tenphuc/Clock-Digital-with-Emotional-Face-and-Environment-Sensors/PROJECT/HW/CLKE.pdf

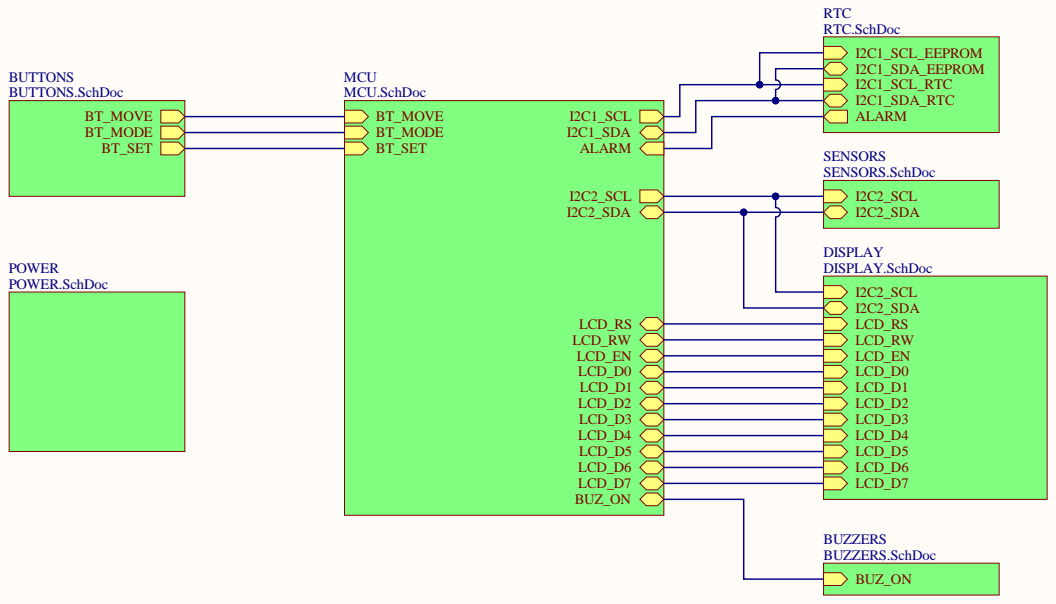
[picture p2: page 1]

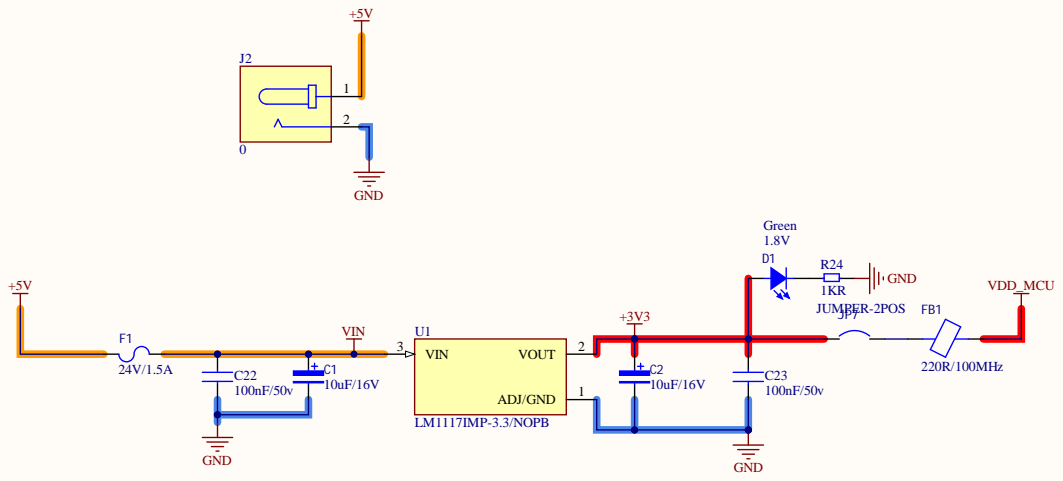
[picture p3: page 2]

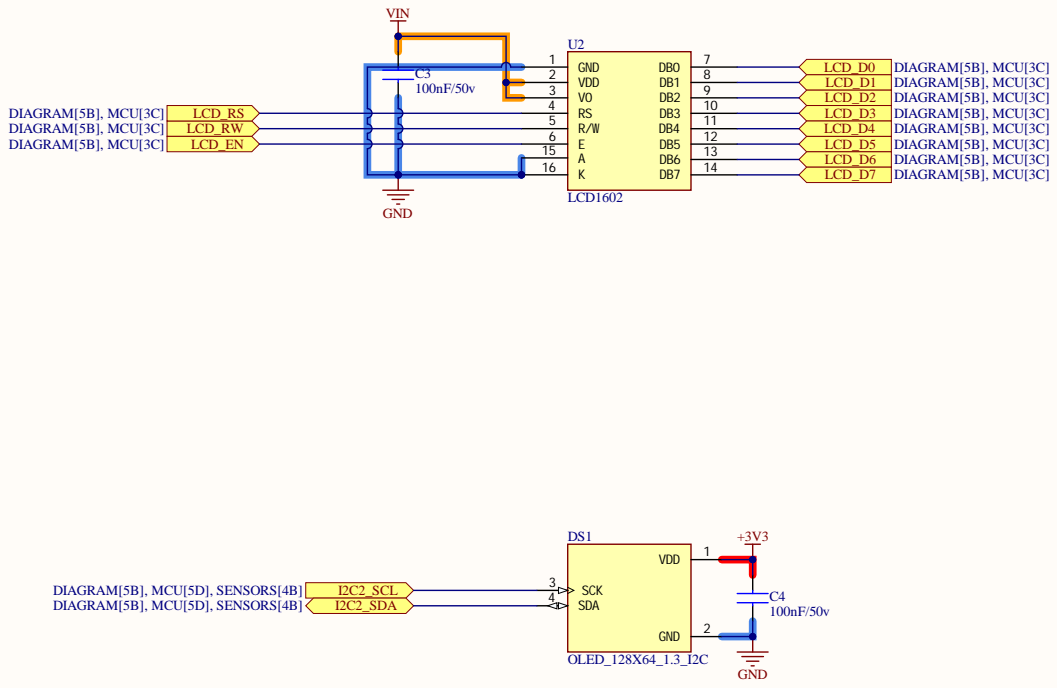
[picture p4: page 3]

C3 | VDD 2
100nF/50v | V0 3

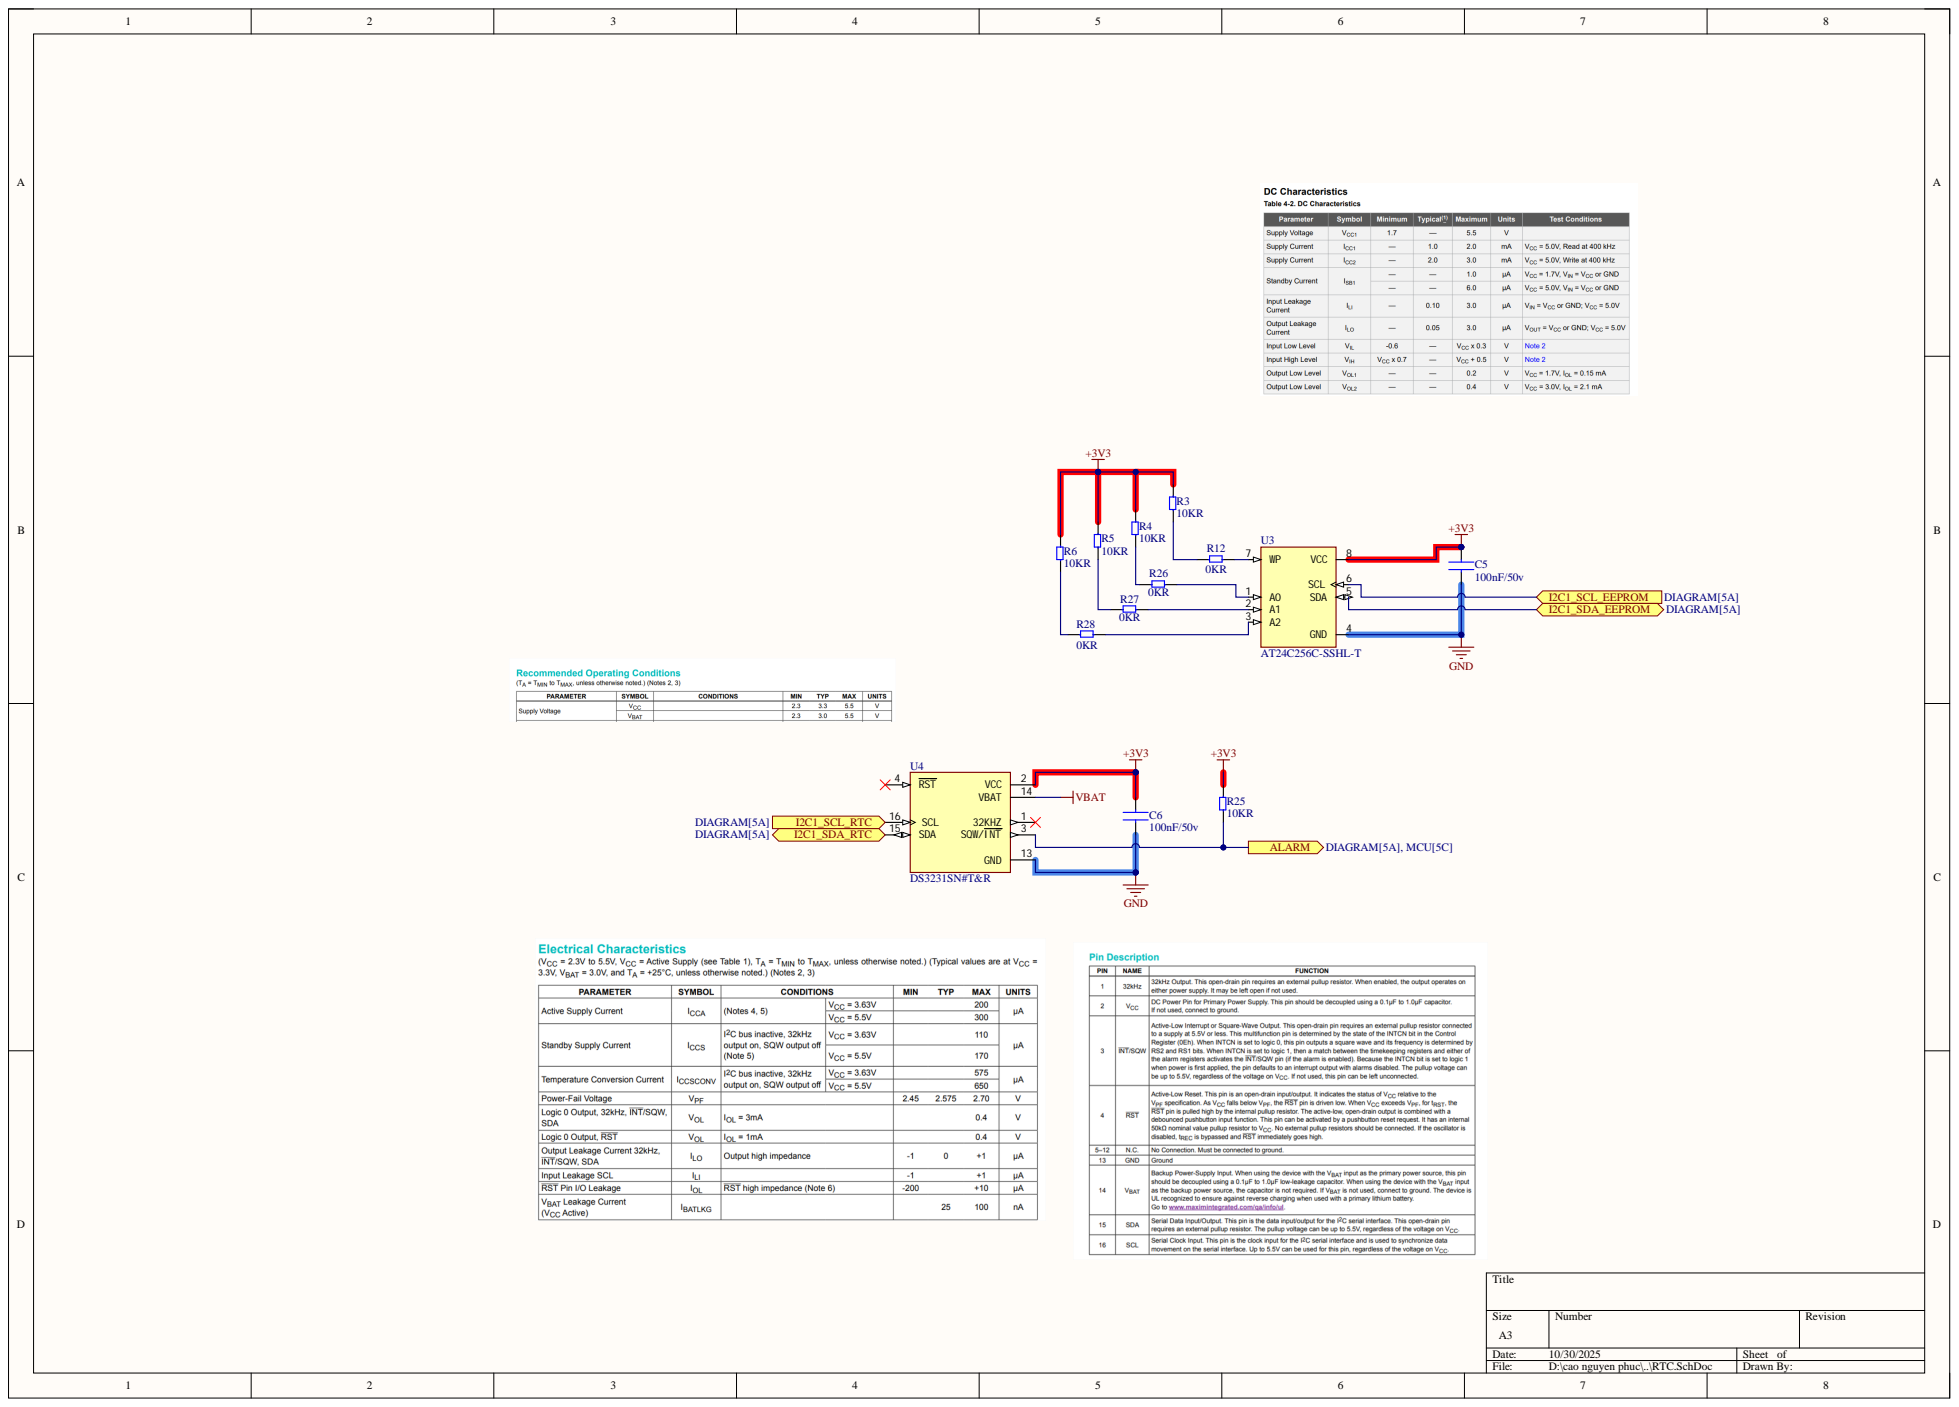
[picture p5: page 4]

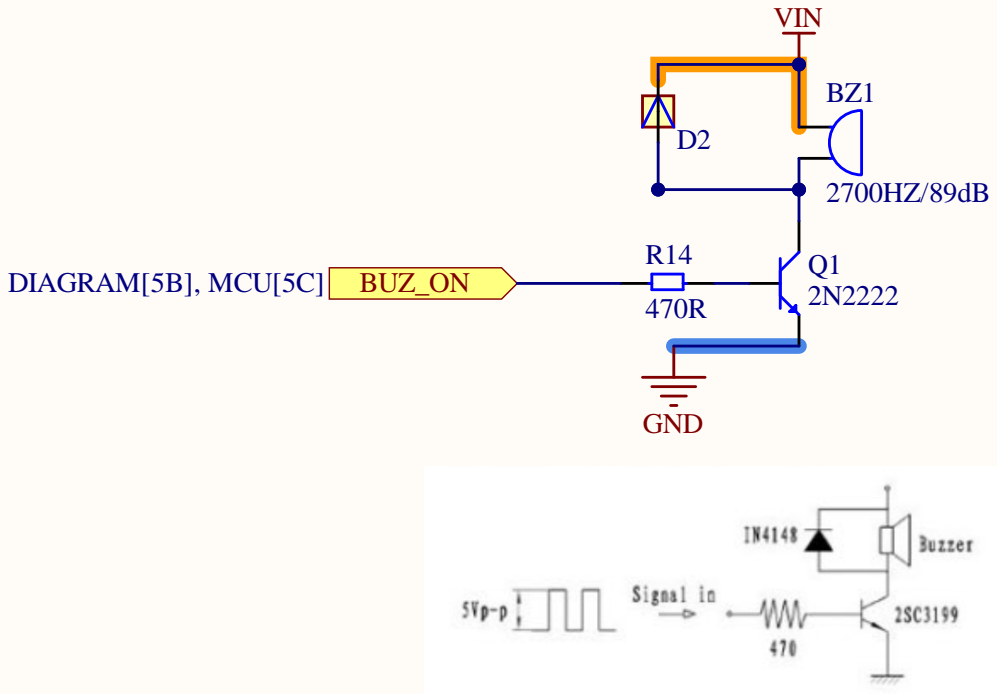
[picture p6: page 5]

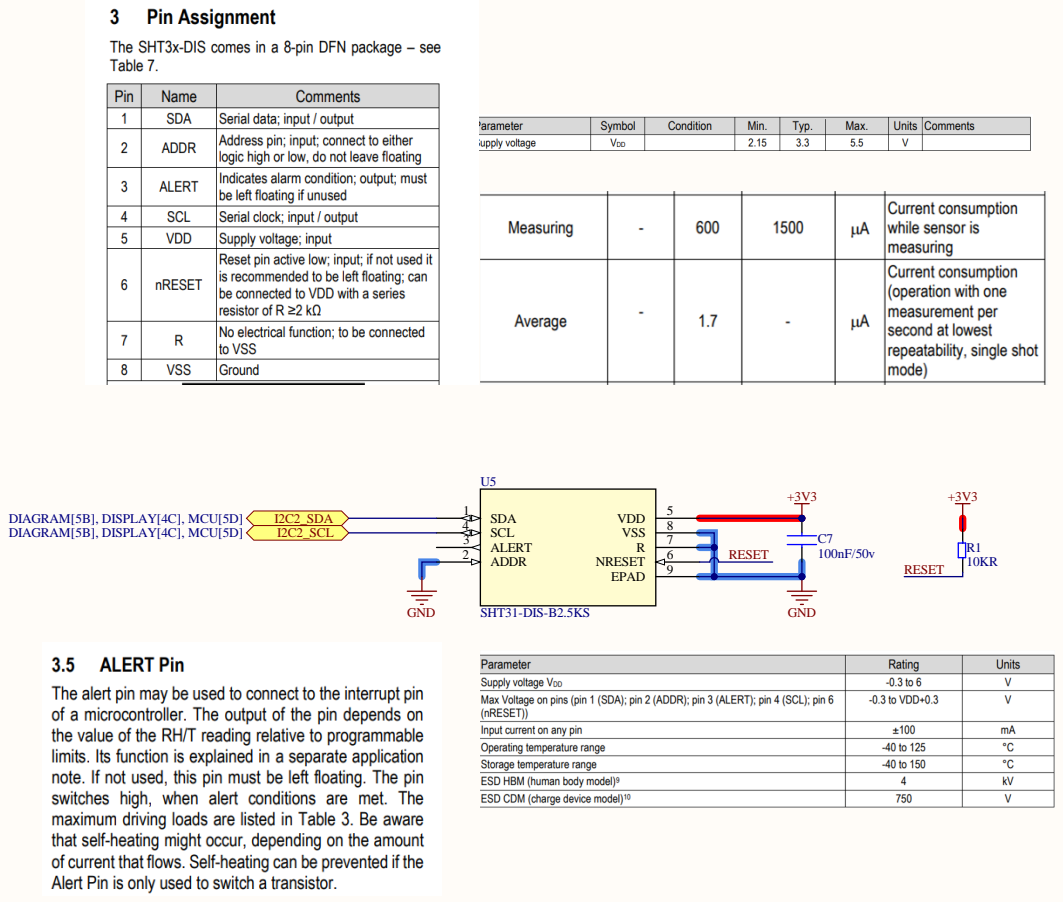
[picture p7: page 6]

\cao nguyen phuc\..\SE

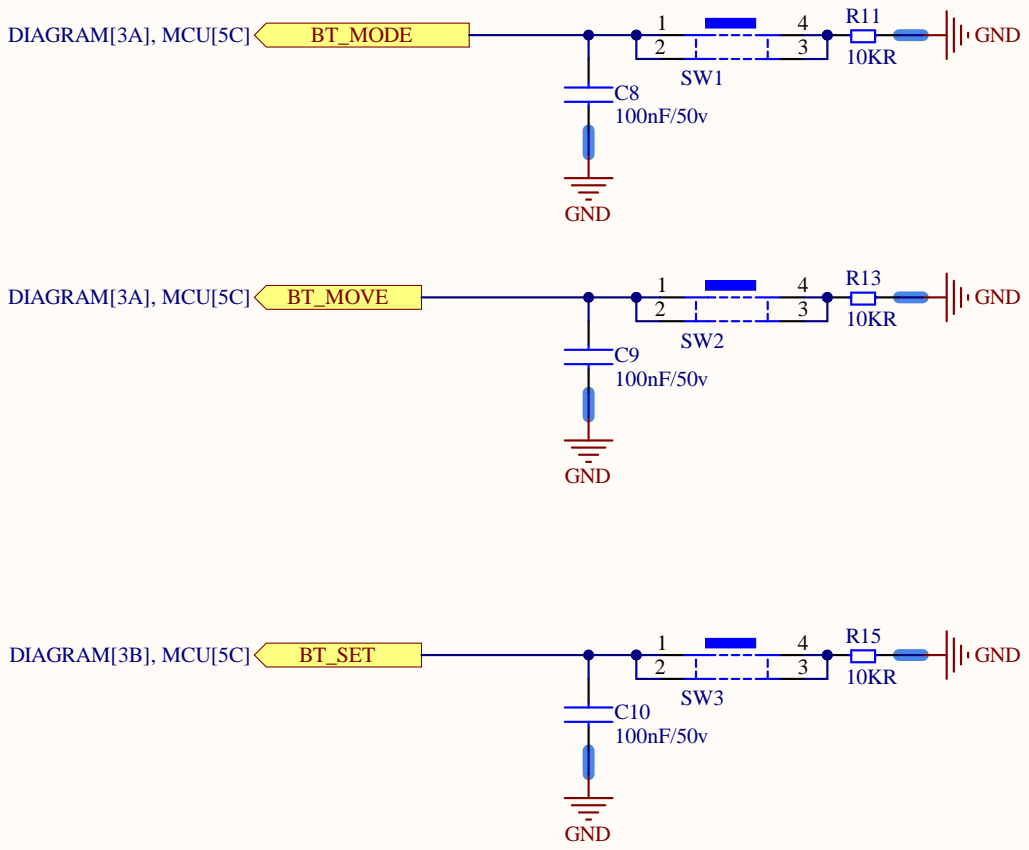
[picture p8: page 7]

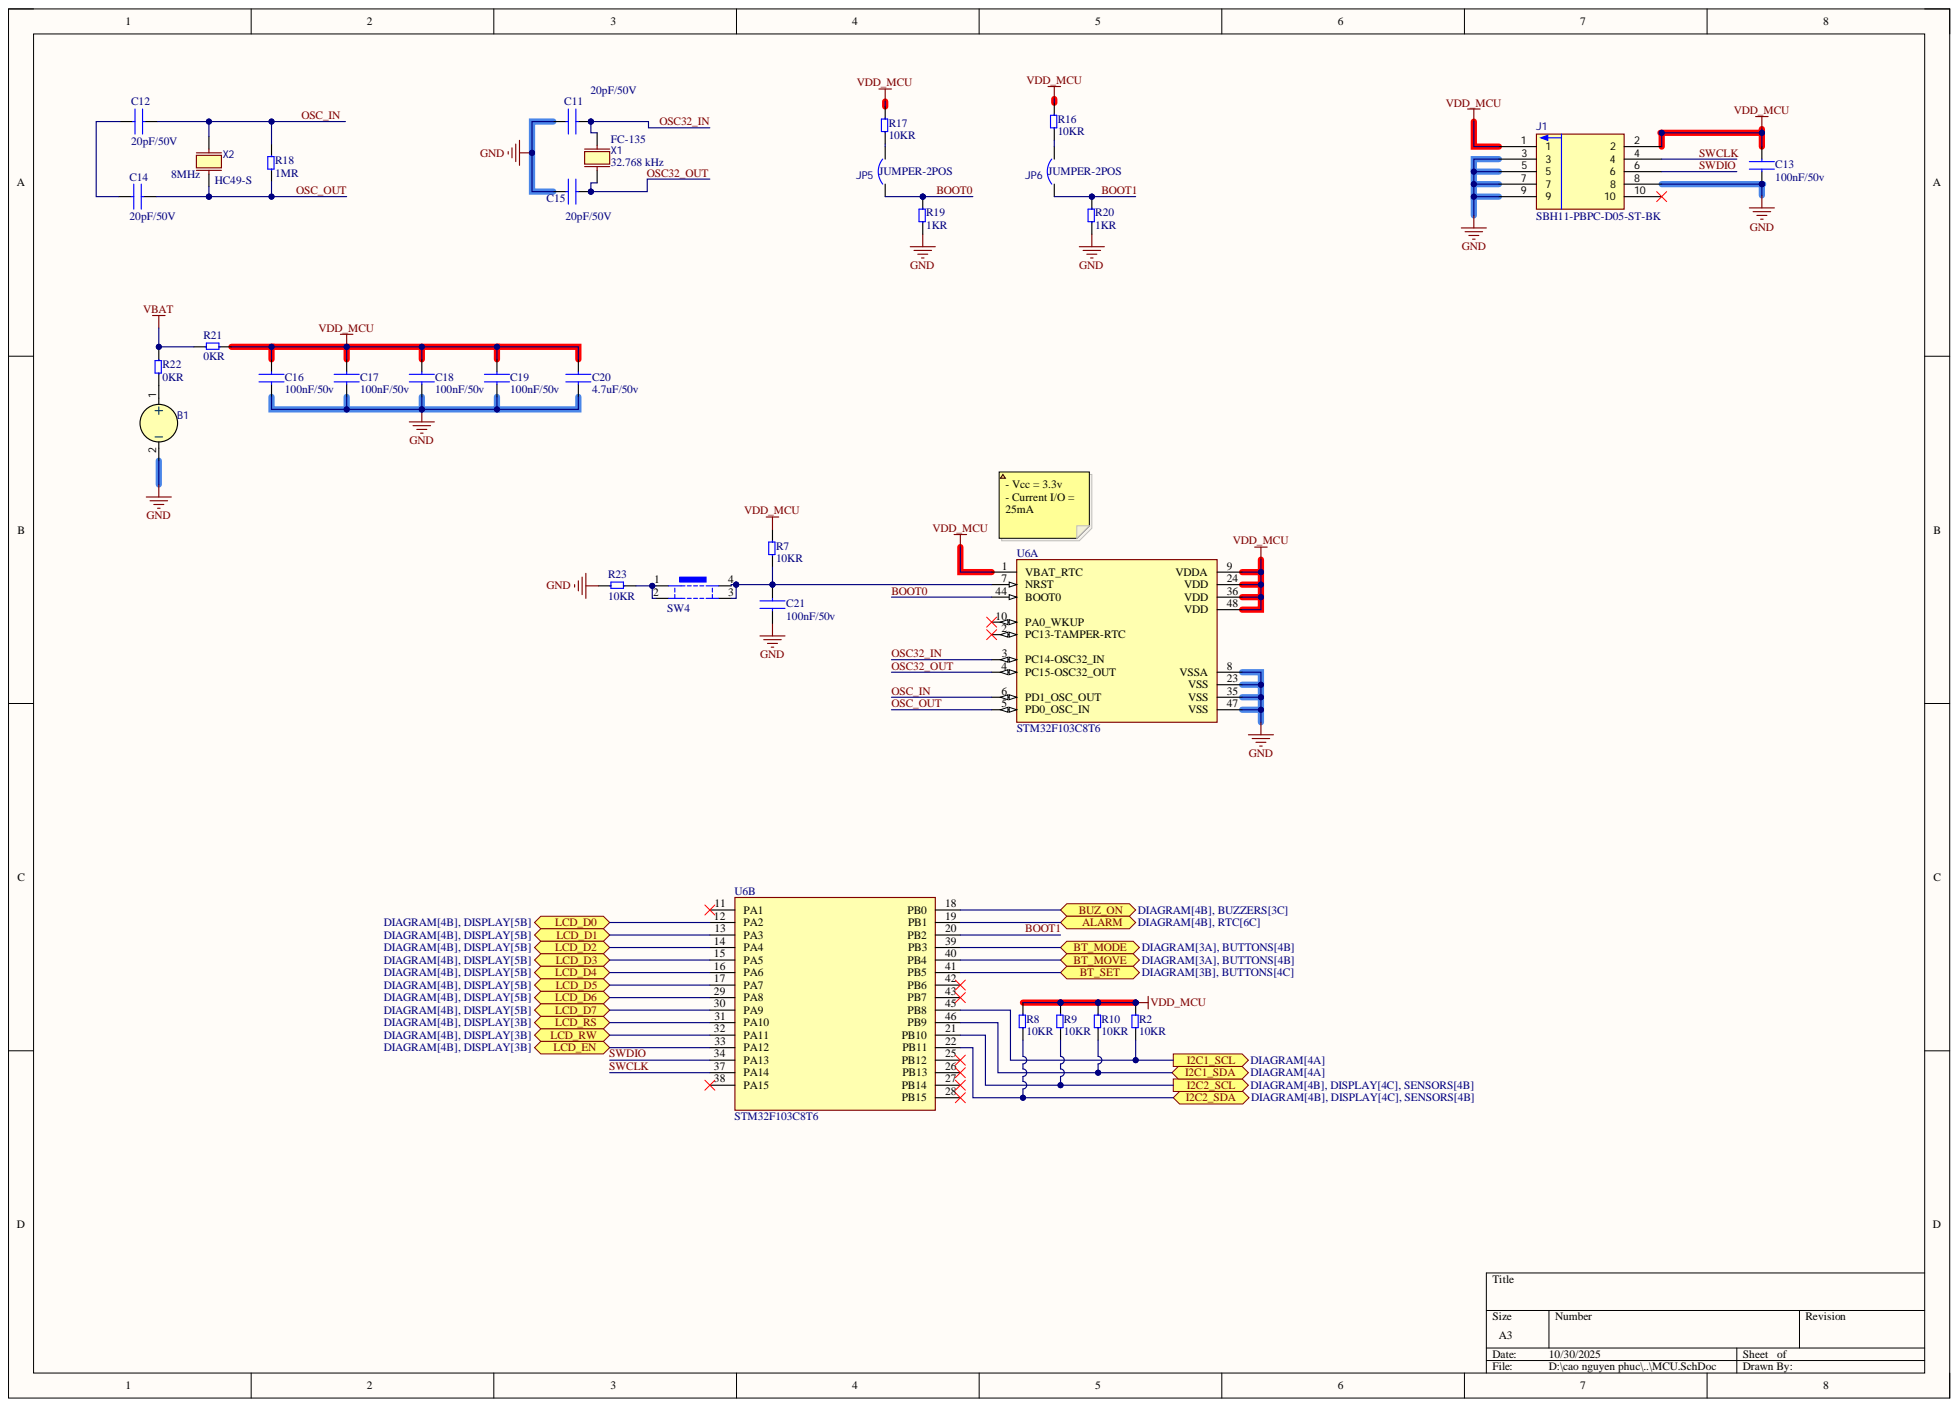
[picture p9: page 8]

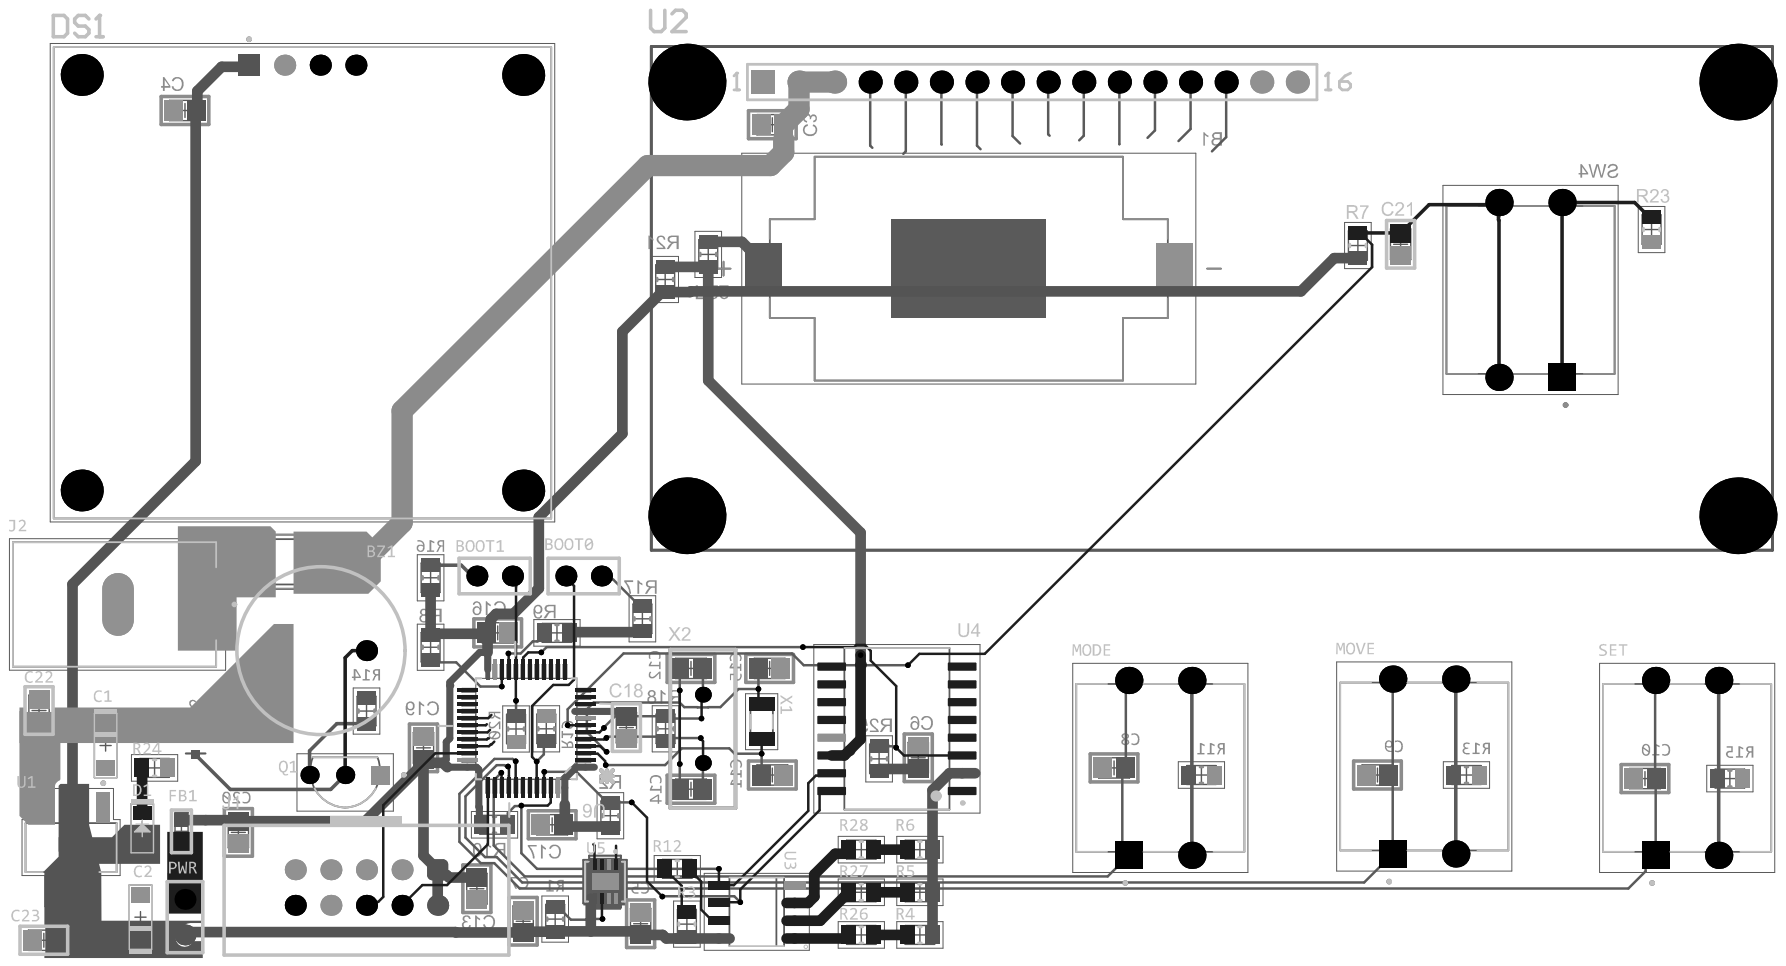
[picture p10: page 9]
