tenphuc/Clock-Digital-with-Emotional-Face-and-Environment-Sensors/(list of files, drawings)

Other design files:
PROJECT/HW/BUTTONS.SchDoc
PROJECT/HW/BUZZERS.SchDoc
PROJECT/HW/CLKE.PrjPcb
PROJECT/HW/CLKE_POWER.SchDoc
PROJECT/HW/DIAGRAM.SchDoc
PROJECT/HW/DISPLAY.SchDoc
PROJECT/HW/INDEX.SchDoc
PROJECT/HW/MCU.SchDoc
PROJECT/HW/PCB1.PcbDoc
PROJECT/HW/POWER.SchDoc
PROJECT/HW/RTC.SchDoc
PROJECT/HW/SENSORS.SchDoc
